mortens-lab/PICO_RS485/PICO-RS485.kicad_pcb

## KiCad design PICO-RS485.kicad_pcb (2025-09-06)

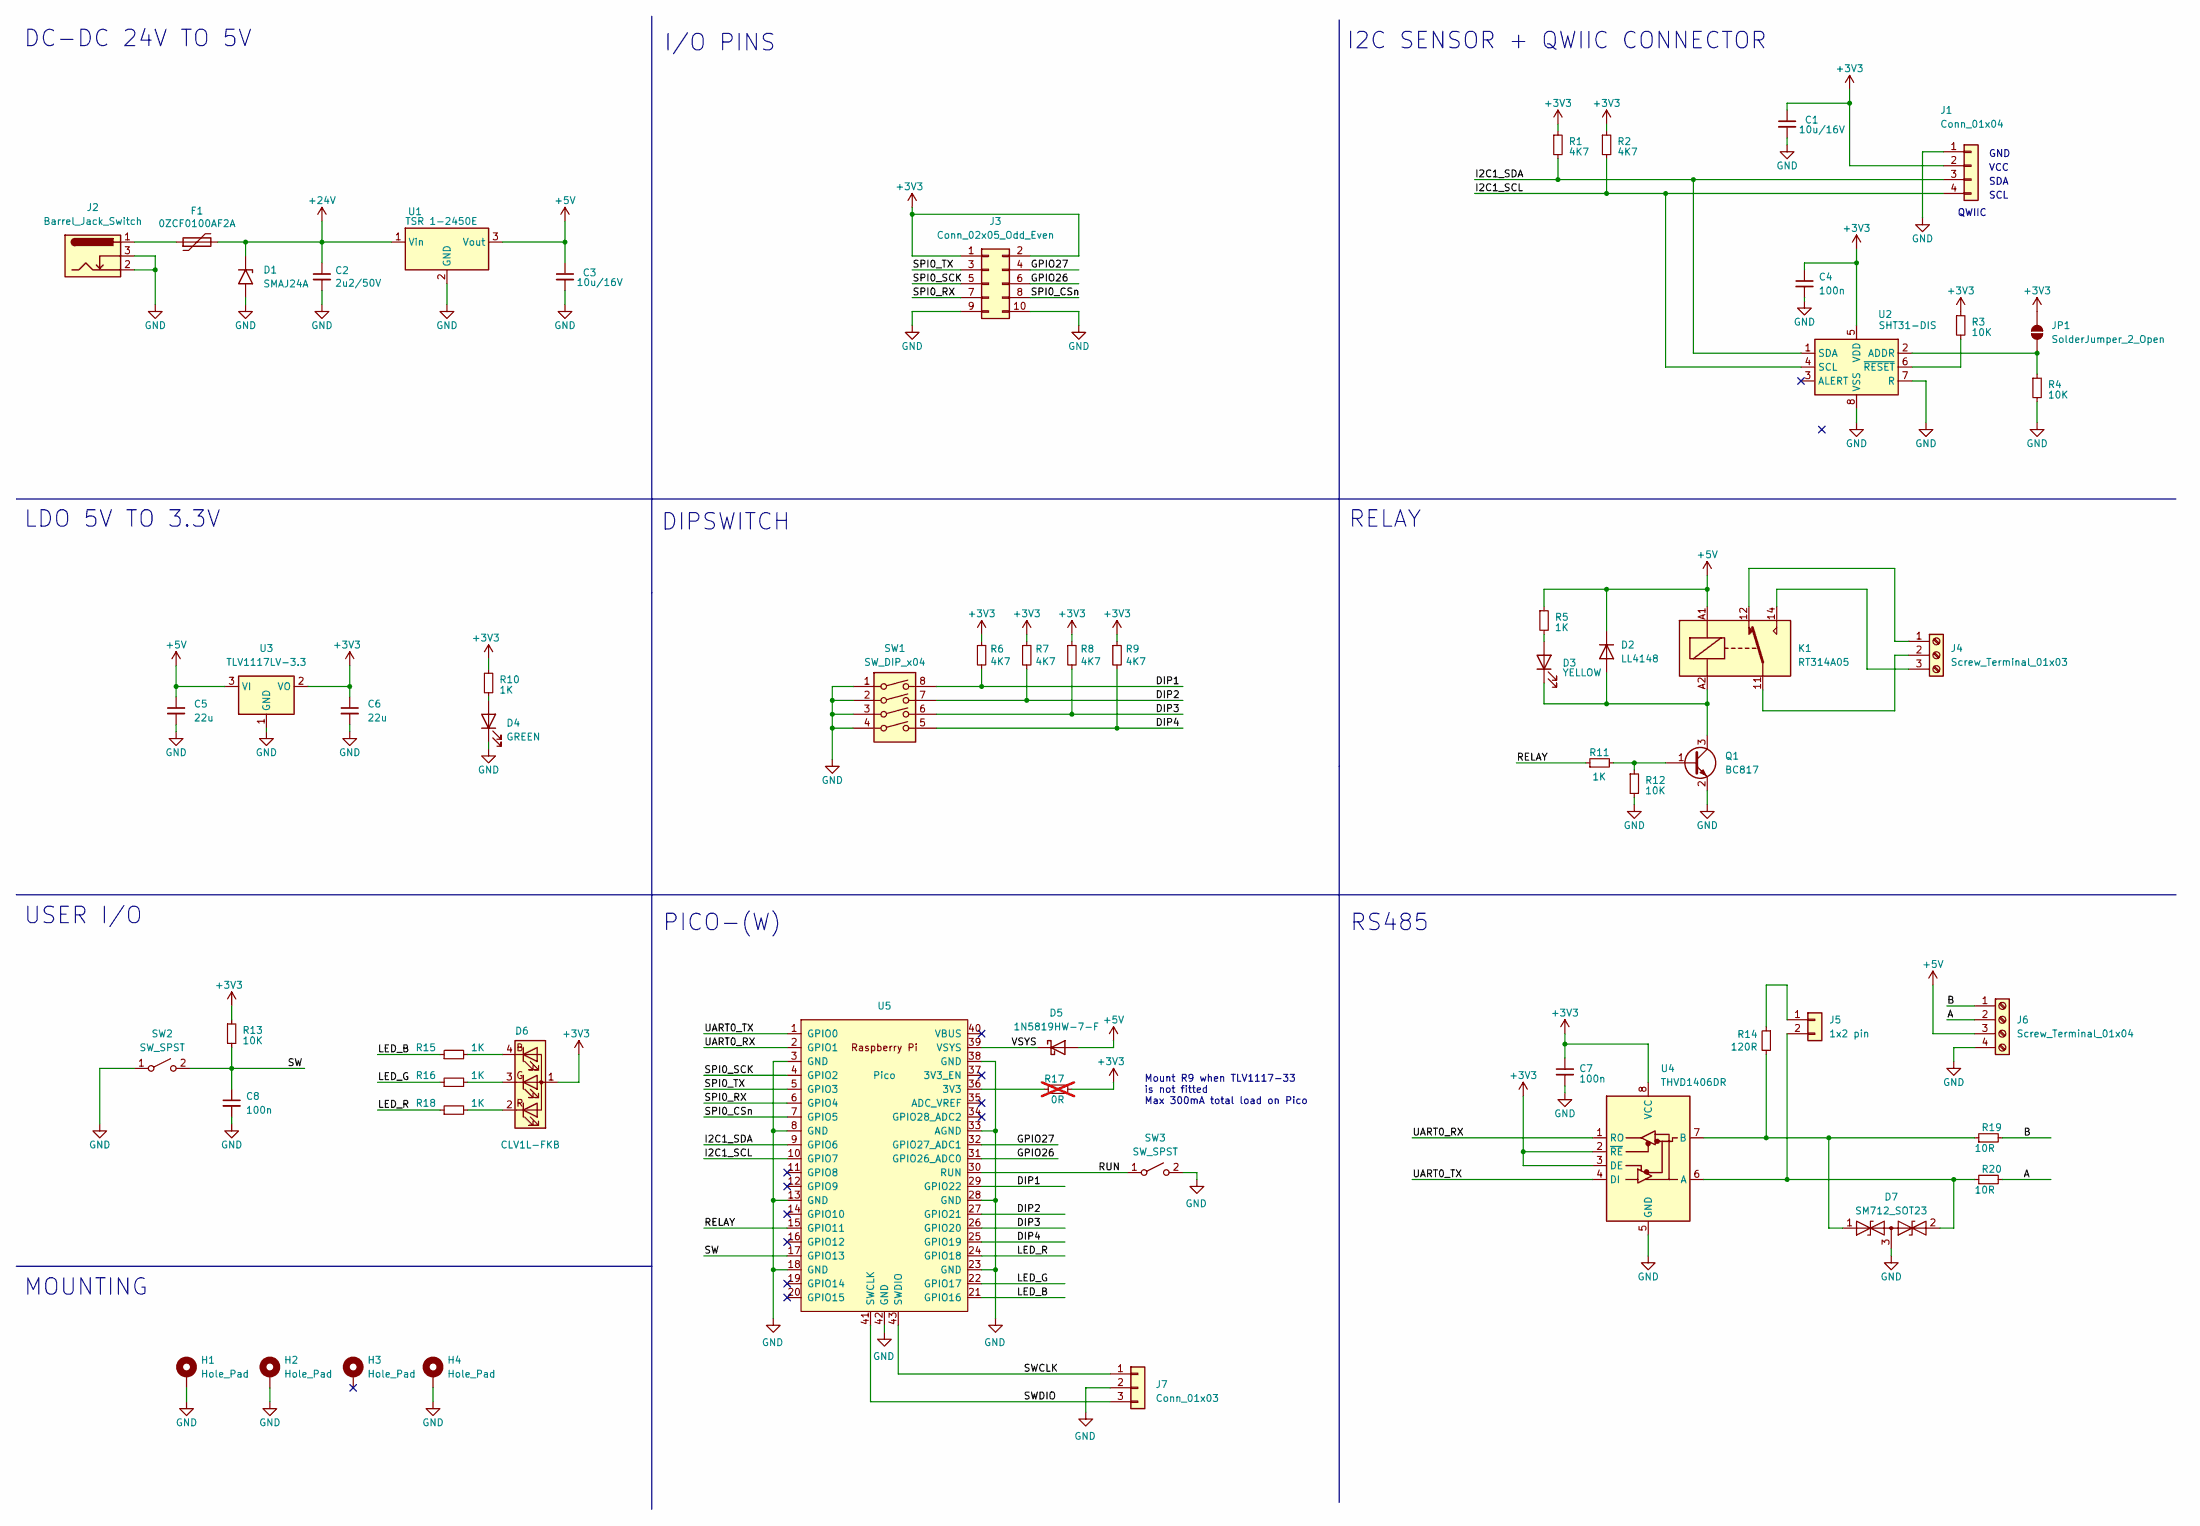
[picture p1: schematic PICO-RS485.kicad_sch, PICO-(W) with RS485 interface (iot-thingy)]

Parts:
C1, C3: 10u/16V; C_0805_2012Metric; Part Number CL21B106KOQNNNE; Mouser 187-CL21B106KOQNNNE
C2: 2u2/50V; C_0805_2012Metric; Part Number CL21B225KBYNNWE; Mouser 187-CL21B225KBYNNWE
C4, C7, C8: 100n; C_0402_1005Metric_Pad0.74x0.62mm_HandSolder; Manufacturer Part # GCM155R71H104KE02J; LCSC C2649549
C5, C6: 22u; C_0805_2012Metric_Pad1.18x1.45mm_HandSolder; Manufacturer Part # GRM21BR61A226ME51L; LCSC C77074
D1: SMAJ24A; D_SMA; Manufacturer Part # SMAJ24A; LCSC C148222
D2: LL4148; D_MiniMELF; Manufacturer Part # LL4148; LCSC C402260
D3: YELLOW; LED_0603_1608Metric_Pad1.05x0.95mm_HandSolder; Manufacturer Part # APTD1608LSYCK; LCSC C5352634
D4: GREEN; LED_0603_1608Metric_Pad1.05x0.95mm_HandSolder; Manufacturer Part # APHD1608LCGCK; LCSC C5139863
D5: 1N5819HW-7-F; D_SOD-323; Manufacturer Part # 1N5819HW-7-F; LCSC C82544
D6: CLV1L-FKB; LED_Cree-PLCC4_3.2x2.8mm_CCW; Manufacturer Part # CLV1L-FKB-CJ1N1E1BB7B3B3; LCSC NA
D7: SM712_SOT23; SOT-23; Manufacturer Part # SM712-02HTG; LCSC C172881
F1: 0ZCF0100AF2A; Fuse_2920_7451Metric; Part Number 0ZCF0100AF2A; Mouser 530-0ZCF0100AF2A
H1, H2, H4: Hole_Pad; MountingHole_3.2mm_M3_DIN965_Pad_TopBottom; Manufacturer Part # DNP; LCSC DNP
H3: Hole_Pad; MountingHole_3.2mm_M3_DIN965; Manufacturer Part # DNP; LCSC DNP
J1: Conn_01x04; JST_SH_SM04B-SRSS-TB_1x04-1MP_P1.00mm_Horizontal; Manufacturer Part # JST SM04B-SRSS-TB(LF)(SN); LCSC C160404
J2: Barrel_Jack_Switch; BarrelJack_Wuerth_6941xx301002; Manufacturer Part # 694106301002; LCSC C720557
J3: Conn_02x05_Odd_Even; PinHeader_2x05_P2.54mm_Vertical; Manufacturer Part # PZ2.54-2X5P-H25; LCSC C42431818
J4: Screw_Terminal_01x03; TerminalBlock_Phoenix_PT-1,5-3-5.0-H_1x03_P5.00mm_Horizontal; Manufacturer Part # 1984633; LCSC C5144867
J5: 1x2 pin; PinHeader_1x02_P2.54mm_Vertical; Part Number DNP; Mouser NA
J6: Screw_Terminal_01x04; TerminalBlock_Phoenix_PT-1,5-4-3.5-H_1x04_P3.50mm_Horizontal; Manufacturer Part # 1935174; LCSC C3816891
J7: Conn_01x03; PinHeader_1x03_P2.54mm_Vertical; Manufacturer Part # DNP; Mouser DNP
JP1: SolderJumper_2_Open; SolderJumper-2_P1.3mm_Open_RoundedPad1.0x1.5mm
K1: RT314A05; Relay_SPDT_Schrack-RT1-16A-FormC_RM5mm; Manufacturer Part # RT314005; LCSC C7065270
Q1: BC817; SOT-23; Manufacturer Part # BC817-40,235; LCSC C503453
R1, R2, R6, R7, R8, R9: 4K7; R_0402_1005Metric_Pad0.72x0.64mm_HandSolder; Manufacturer Part # CRCW04024K70FKED; Mouser 71-CRCW0402-4.7K-E3
R3, R4, R12, R13: 10K; R_0402_1005Metric_Pad0.72x0.64mm_HandSolder; Manufacturer Part # CRCW040210K0FKED; LCSC C71617
R5, R10, R11, R15, R16, R18: 1K; R_0402_1005Metric_Pad0.72x0.64mm_HandSolder; Manufacturer Part # CRCW04021K00FKED; LCSC C71623
R14: 120R; R_1206_3216Metric_Pad1.30x1.75mm_HandSolder; Manufacturer Part # CRCW1206120RFKEAC; Mouser 71-CRCW1206120RFKEAC
R17: 0R; R_0603_1608Metric; Manufacturer Part # RC0603JR-070RL; Mouser 603-RC0603JR-070RL; not fitted
R19, R20: 10R; R_0402_1005Metric_Pad0.72x0.64mm_HandSolder; Manufacturer Part # CRCW040210R0FKED; LCSC C481926
SW1: SW_DIP_x04; SW_DIP_SPSTx04_Slide_Omron_A6S-410x_W8.9mm_P2.54mm; Manufacturer Part # A6S-4101-H; LCSC C5123696
SW2: SW_SPST; SW_Tactile_SPST_Angled_PTS645Vx31-2LFS; Manufacturer Part # DTSA-61K-V; LCSC C483771
SW3: SW_SPST; SW_SPST_B3U-1000P
U1: TSR 1-2450E; Converter_DCDC_TRACO_TSR-1_THT; Part Number TSR 1-2450E; Mouser 495-TSR1-2450E
U2: SHT31-DIS; Sensirion_DFN-8-1EP_2.5x2.5mm_P0.5mm_EP1.1x1.7mm; Manufacturer Part # SHT31-DIS-F2.5kS; LCSC NA
U3: TLV1117LV-3.3; SOT-223-3_TabPin2; Manufacturer Part # TLV1117LV33DCYR; LCSC C48937499
U4: THVD1406DR; SOIC-8_3.9x4.9mm_P1.27mm; Manufacturer Part # HVD1406DR; LCSC C5215918
U5: Pico; Raspberry_Pi_Pico_SMT_THT; Manufacturer Part # Raspberry Pi PICO W; Mouser 358-SC0918

Connections:
+3V3: C1.1, C4.1, C6.1, C7.1, D6.1 (A), J1.2, J3.1, J3.2, JP1.2 (B), R1.1, R2.1, R3.1, R6.1, R7.1, R8.1, R9.1, R10.1, R13.1, R17.2, U2.5 (VDD), U3.2 (VO), U4.2 (~RE), U4.3 (DE), U4.8 (VCC)
+5V: C3.1, C5.1, D2.1 (K), D5.2 (A), J6.3, K1.A1, R5.1, U1.3 (Vout), U3.3 (VI)
+24V: C2.1, D1.1 (A1), F1.2, U1.1 (Vin)
/A: J6.2, R20.2
/B: J6.1, R19.2
/DIP1: R6.2, SW1.8, U5.29 (GPIO22)
/DIP2: R7.2, SW1.7, U5.27 (GPIO21)
/DIP3: R8.2, SW1.6, U5.26 (GPIO20)
/DIP4: R9.2, SW1.5, U5.25 (GPIO19)
/GPIO26: J3.6, U5.31 (GPIO26_ADC0)
/GPIO27: J3.4, U5.32 (GPIO27_ADC1)
/I2C1_SCL: J1.4, R2.2, U2.4 (SCL), U5.10 (GPIO7)
/I2C1_SDA: J1.3, R1.2, U2.1 (SDA), U5.9 (GPIO6)
/LED_B: R15.1, U5.21 (GPIO16)
/LED_G: R16.1, U5.22 (GPIO17)
/LED_R: R18.1, U5.24 (GPIO18)
/RELAY: R11.1, U5.15 (GPIO11)
/RUN: SW3.1 (A), U5.30 (RUN)
/SPI0_CSn: J3.8, U5.7 (GPIO5)
/SPI0_RX: J3.7, U5.6 (GPIO4)
/SPI0_SCK: J3.5, U5.4 (GPIO2)
/SPI0_TX: J3.3, U5.5 (GPIO3)
/SW: C8.1, R13.2, SW2.2 (B), U5.17 (GPIO13)
/SWCLK: J7.1, U5.43 (SWDIO)
/SWDIO: J7.3, U5.41 (SWCLK)
/UART0_RX: U4.1 (RO), U5.2 (GPIO1)
/UART0_TX: U4.4 (DI), U5.1 (GPIO0)
/VSYS: D5.1 (K), U5.39 (VSYS)
GND: C1.2, C2.2, C3.2, C4.2, C5.2, C6.2, C7.2, C8.2, D1.2 (A2), D4.1 (K), D7.3 (common), H1.1, H2.1, H4.1, J1.1, J2.2, J2.3, J3.9, J3.10, J6.4, J7.2, Q1.2 (E), R4.2, R12.2, SW1.1, SW1.2, SW1.3, SW1.4, SW2.1 (A), SW3.2 (B), U1.2 (GND), U2.7 (R), U2.8 (VSS), U2.9 (VSS), U3.1 (GND), U4.5 (GND), U5.3 (GND), U5.8 (GND), U5.13 (GND), U5.18 (GND), U5.23 (GND), U5.28 (GND), U5.33 (AGND), U5.38 (GND), U5.42 (GND)
unnamed: D2.2 (A), D3.1 (K), K1.A2, Q1.3 (C)
unnamed: D3.2 (A), R5.2
unnamed: D4.2 (A), R10.2
unnamed: D6.4 (BK), R15.2
unnamed: D6.3 (GK), R16.2
unnamed: D6.2 (RK), R18.2
unnamed: D7.1 (A1), R14.2, R19.1, U4.7 (B)
unnamed: D7.2 (A2), J5.2, R20.1, U4.6 (A)
unnamed: F1.1, J2.1
unnamed: J4.1, K1.12
unnamed: J4.2, K1.11
unnamed: J4.3, K1.14
unnamed: J5.1, R14.1
unnamed: JP1.1 (A), R4.1, U2.2 (ADDR)
unnamed: Q1.1 (B), R11.2, R12.1
unnamed: R3.2, U2.6 (~RESET)
unnamed: R17.1, U5.36 (3V3)

Notes on the sheet:
PICO-(W)
LDO 5V TO 3.3V
Mount R9 when TLV1117-33 is not fitted Max 300mA total load on Pico
USER I/O
RELAY
MOUNTING
SCL
I2C SENSOR + QWIIC CONNECTOR
SDA
I/O PINS
DIPSWITCH
QWIIC
VCC
RS485
GND
DC-DC 24V TO 5V

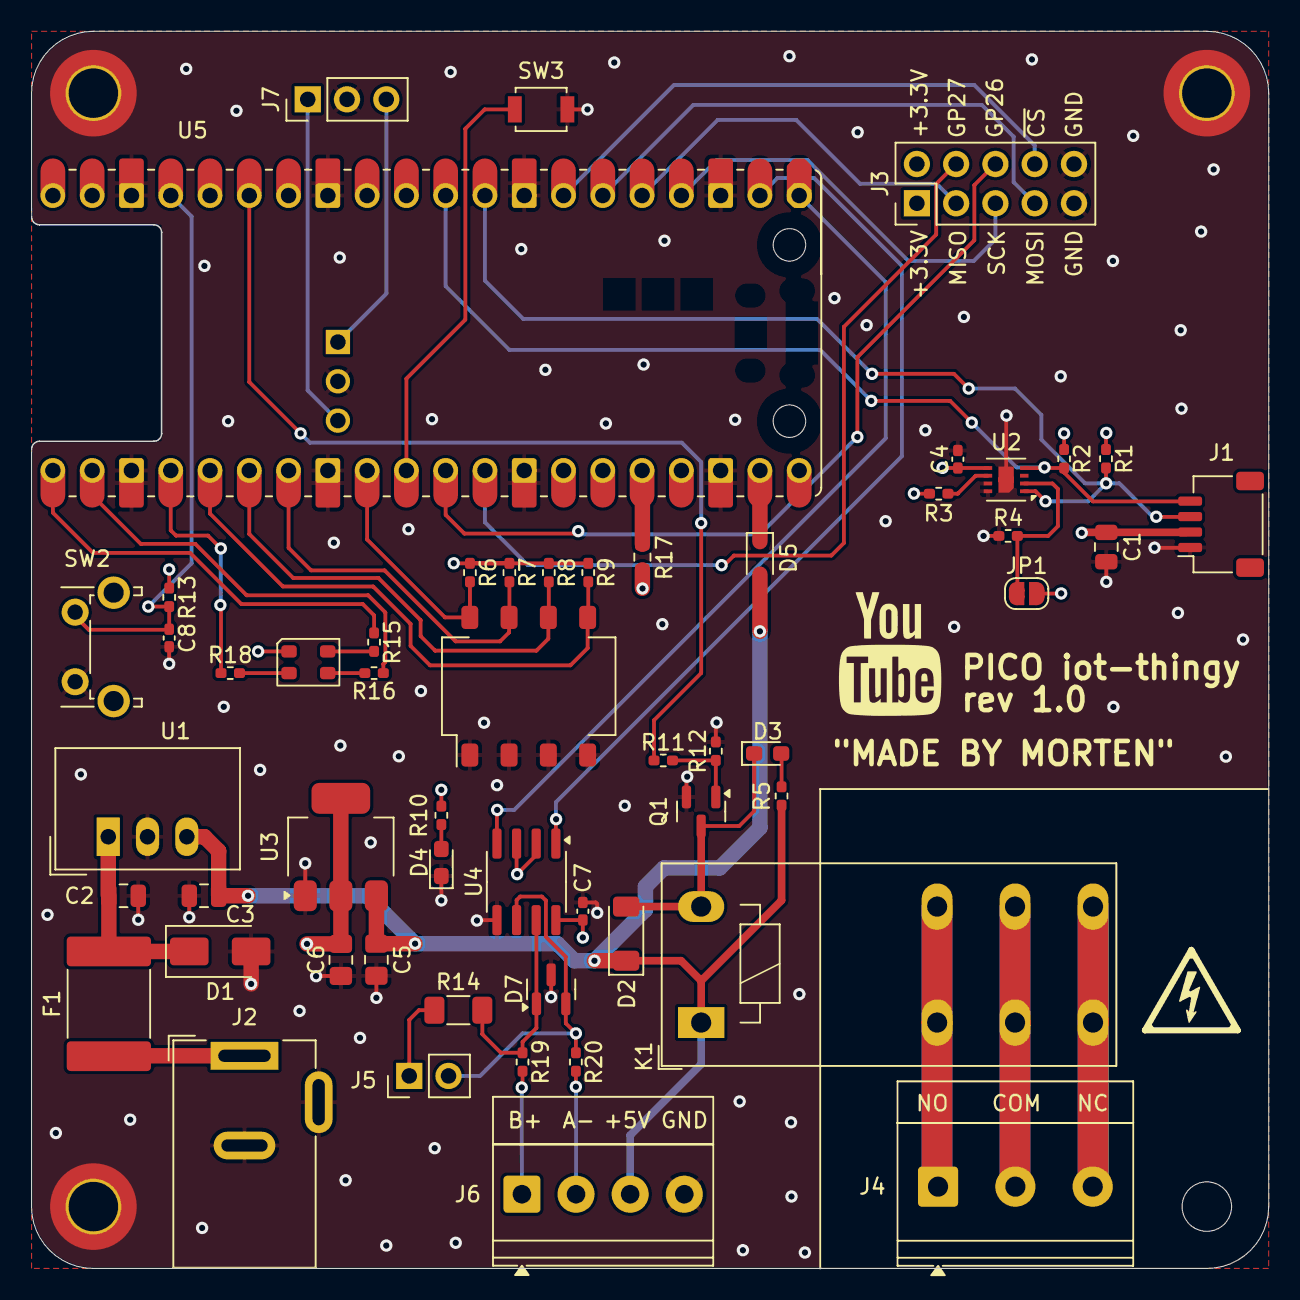
[picture p2: board PICO-RS485.kicad_pcb from above]

Board: 4 copper layers, 80.0 x 80.0 mm, 58 parts (0 on the bottom side), 46 nets.
